limpkin/cdm324_backpack/pictures/cdm324_assembled_quarter.JPG

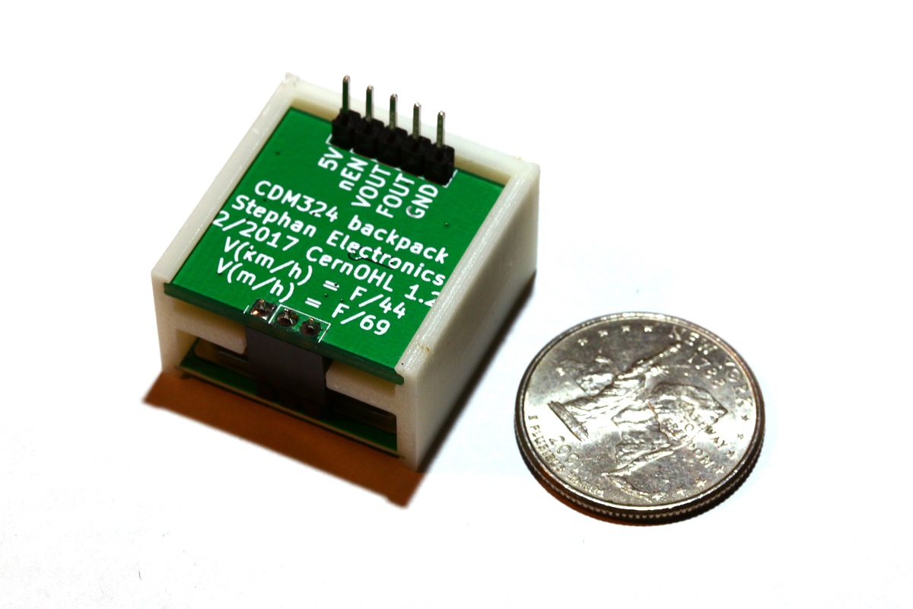
pictures/cdm324_assembled_quarter.JPG
