limpkin/cdm324_backpack/pictures/cdm324_assembled_patch.JPG

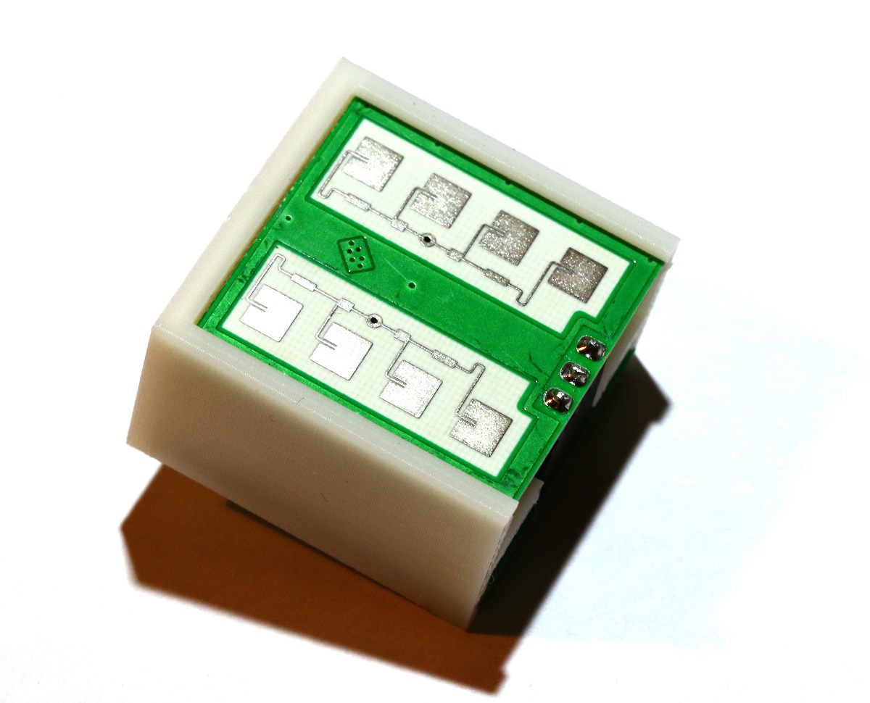
pictures/cdm324_assembled_patch.JPG
