limpkin/cdm324_backpack/pictures/cdm324_pcb1.JPG

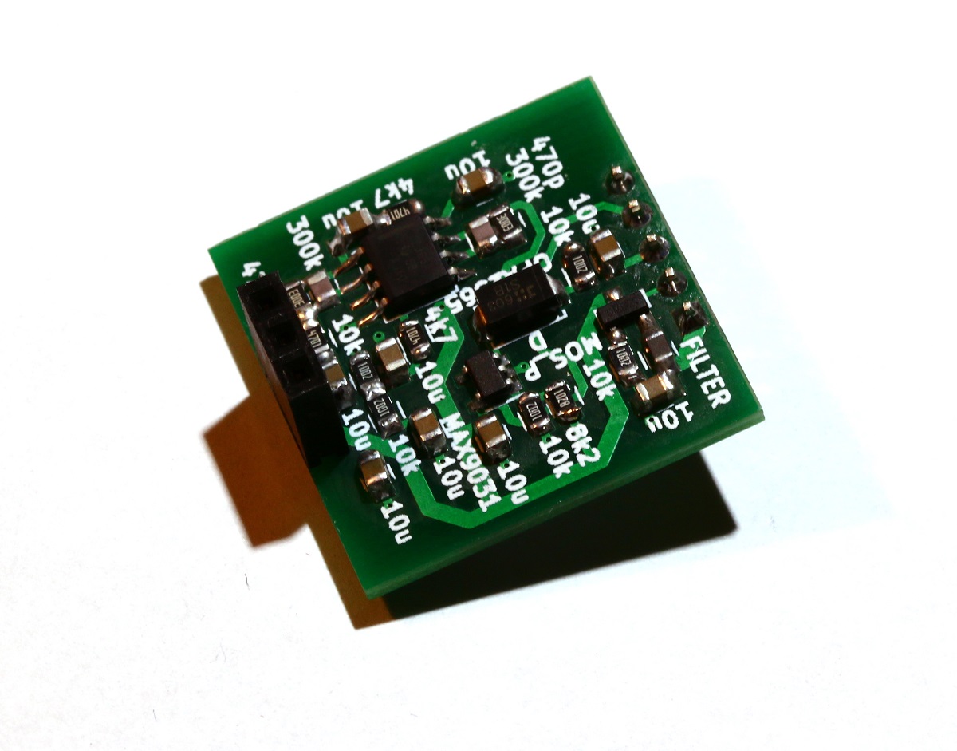
pictures/cdm324_pcb1.JPG
