limpkin/cdm324_backpack/pictures/cdm324_pcb2.JPG

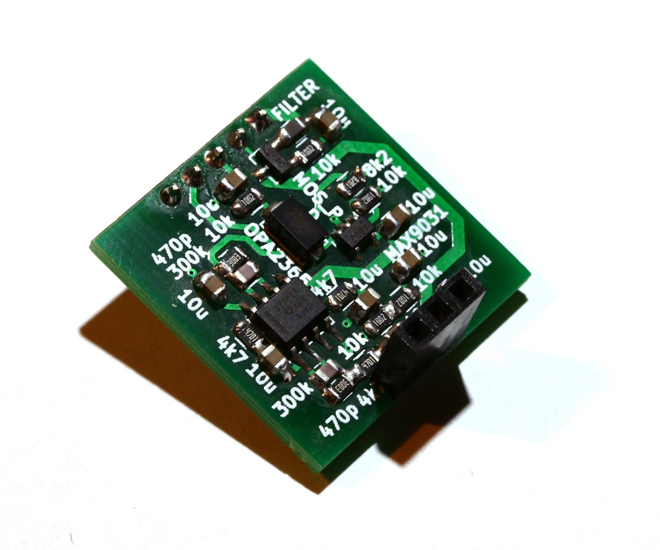
pictures/cdm324_pcb2.JPG
