limpkin/cdm324_backpack/pictures/cdm324_size.JPG

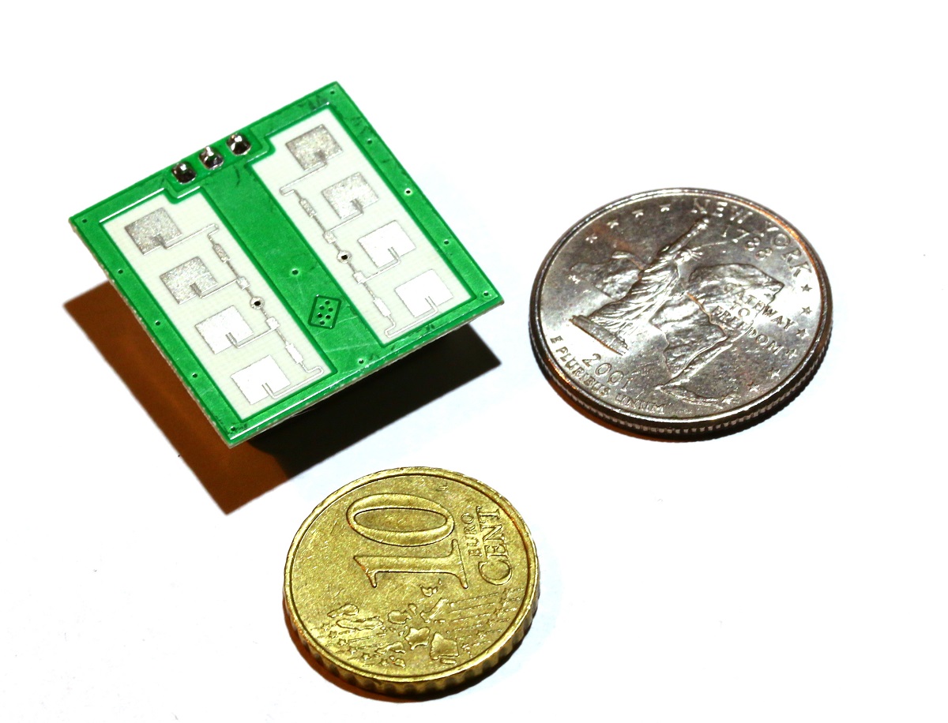
pictures/cdm324_size.JPG
