limpkin/cdm324_backpack/BoM.xlsx

 | Prototype Quantity | 10
Item | References | Qty | Manufacturer P/N | Manufacturer | Description | Package | Internet Link | Home ID | Part Status
1 | U1 | 1 | OPA2365AIDR | Texas Instruments | IC OPAMP GP 50MHZ RRO 8SOIC | 8-SOIC | http://www.digikey.com/product-detail/en/OPA2365AIDR/296-31704-1-ND/3505181 | ---- | Active
2 | R2 R3 R10 R11 R1 | 5 | RC0805FR-0710KL | Yageo | RES SMD 10K OHM 1% 1/8W 0805 | 0805 | http://www.digikey.com/product-detail/en/yageo/RC0805FR-0710KL/311-10.0KCRCT-ND/730482 | ---- | Active
3 | FB1 | 1 | HZ0805D102R-10 | Laird-Signal Integrity Products | FERRITE BEAD 1 KOHM 0805 1LN | 0805 (2012 Metric) | http://www.digikey.com/product-detail/en/HZ0805D102R-10/240-2397-1-ND/806757 | ---- | Active
4 | P2 | 1 | PPPC031LFBN-RC | Sullins Connector Solutions | CONN HEADER FEMALE 3POS .1" GOLD |  | http://www.digikey.com/product-detail/en/sullins-connector-solutions/PPPC031LFBN-RC/S7036-ND/810175 | ---- | Active
5 | C3 C4 C1 C2 C8 C5 C9 C11 C10 | 9 | CL21B106KOQNNNE | Samsung Electro-Mechanics America, Inc. | CAP CER 10UF 16V X7R 0805 | 0805 (2012 Metric) | http://www.digikey.com/product-detail/en/samsung-electro-mechanics-america-inc/CL21B106KOQNNNE/1276-2872-1-ND/3890958 | ---- | Active
6 | R4 R5 R6 | 3 | RC0805FR-074K7L | Yageo | RES SMD 4.7K OHM 1% 1/8W 0805 | 0805 | http://www.digikey.com/product-detail/en/yageo/RC0805FR-074K7L/311-4.70KCRCT-ND/730876 | ---- | Active
7 | R7 R8 | 2 | ERJ-6ENF5903V | Panasonic Electronic Components | RES SMD 590K OHM 1% 1/8W 0805 | 0805 | http://www.digikey.com/product-detail/en/panasonic-electronic-components/ERJ-6ENF5903V/P590KCCT-ND/119773 | ---- | Active
8 | C6 C7 | 2 | CC0805JRNPO9BN271 | Yageo | CAP CER 270PF 50V NPO 0805 | 0805 (2012 Metric) | http://www.digikey.com/product-detail/en/yageo/CC0805JRNPO9BN271/311-1116-1-ND/303026 | ---- | Active
9 | U2 | 1 | MAX9031AUK+T | Maxim Integrated | IC COMPARATOR VOLT SGL SOT23-5 | SOT-23-5 | http://www.digikey.com/product-detail/en/MAX9031AUK%2BT/MAX9031AUK%2BTCT-ND/774161 | ---- | Active
10 | R9 | 1 | RC0805FR-078K2L | Yageo | RES SMD 8.2K OHM 1% 1/8W 0805 | 0805 | http://www.digikey.com/product-detail/en/yageo/RC0805FR-078K2L/311-8.20KCRCT-ND/731094 | ---- | Active
11 | D1 | 1 | S1B-13-F | Diodes Incorporated | DIODE GEN PURP 100V 1A SMA | SMA | http://www.digikey.com/product-detail/en/diodes-incorporated/S1B-13-F/S1B-FDICT-ND/725064 | ---- | Active
12 | Q1 | 1 | DMP3098L-7 | Diodes Incorporated | MOSFET P-CH 30V 3.8A SOT23-3 | SOT-23-3 | http://www.digikey.com/product-detail/en/diodes-incorporated/DMP3098L-7/DMP3098LDICT-ND/1964773 | ---- | Active
13 | P1 | 1 |  |  | Standard 5x1 0.1" straight male header
 | Total: | 28
