limpkin/cdm324_backpack/mechanics/assembly.STL

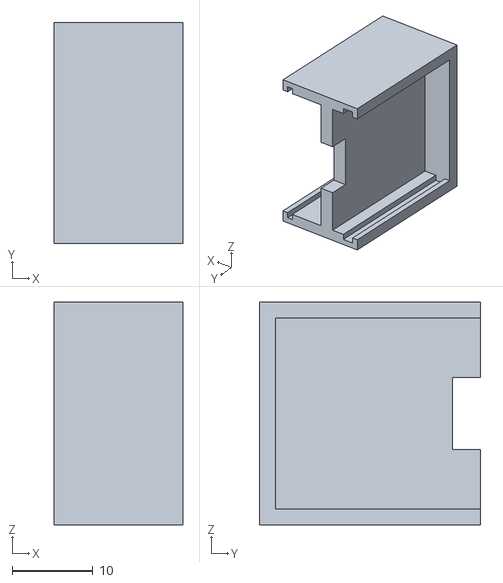
[picture p6: CAD file, 2017-03-27]
mechanics/assembly.STL
16.0 x 27.5 x 27.7
