limpkin/cdm324_backpack/schematics.pdf

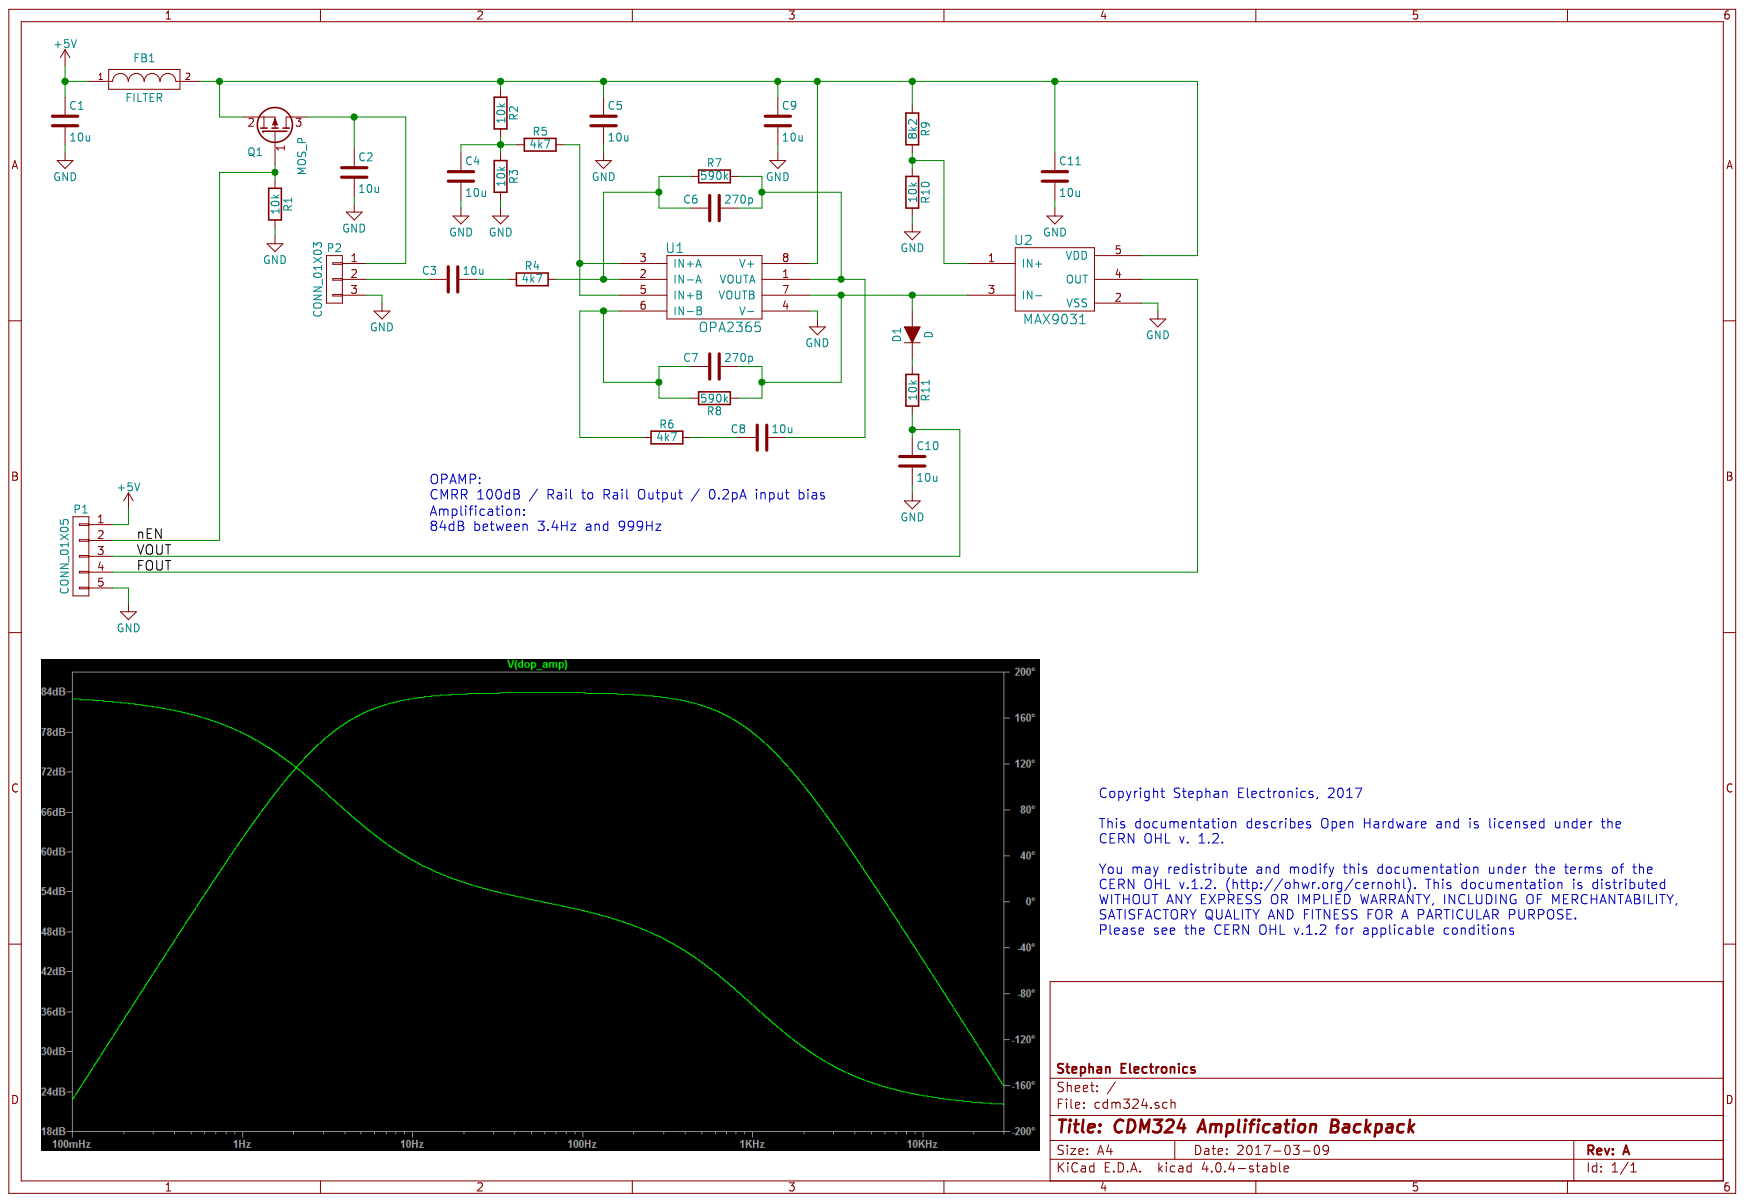
[picture p7: page 1]
