limpkin/cdm324_backpack/kicad/cdm324.kicad_pcb

## KiCad design kicad/cdm324.kicad_pcb (2017-03-27)

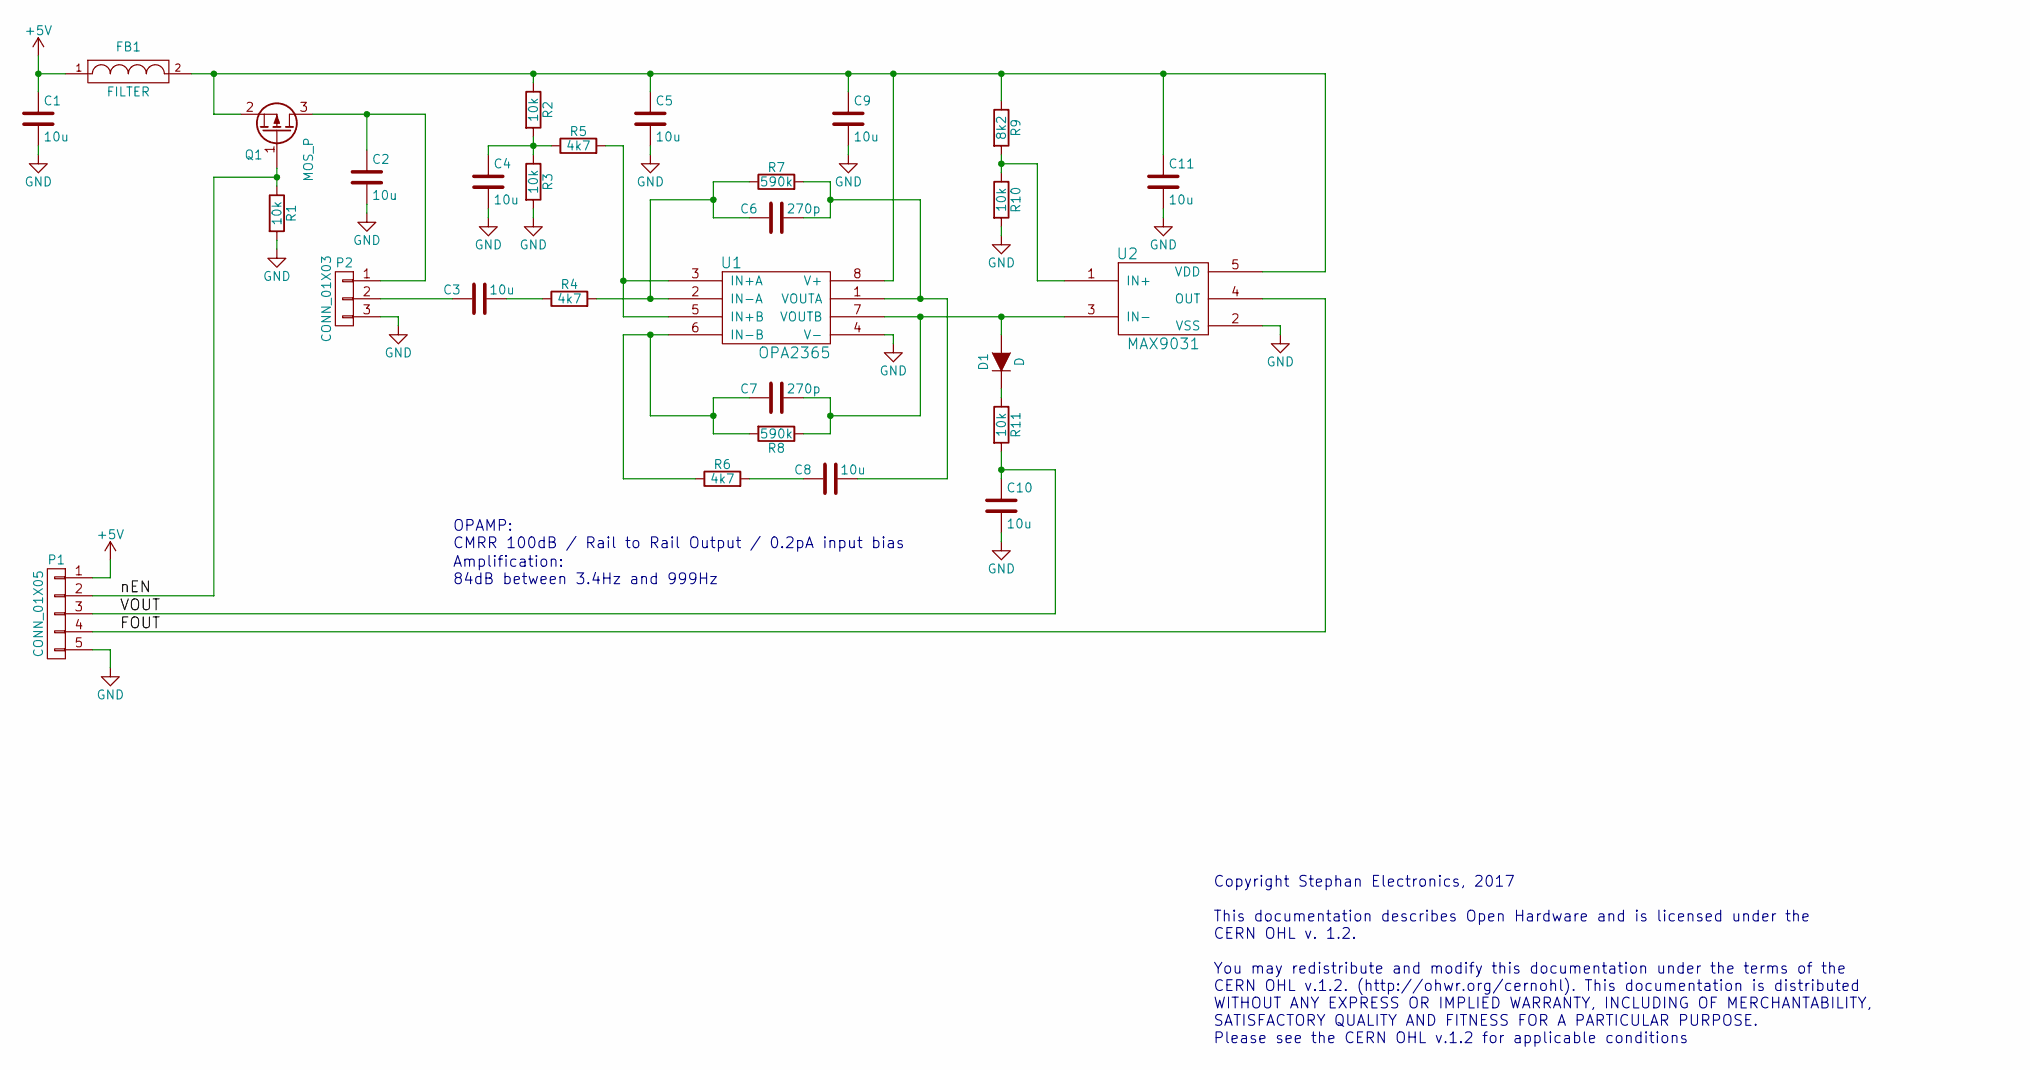
[picture p8: schematic cdm324.sch, CDM324 Amplification Backpack]

Parts:
C1, C2, C3, C4, C5, C8, C9, C10, C11: 10u; C_0805
C6, C7: 270p; C_0805
D1: D; DIODE_SMA
FB1: FILTER; C_0805
P1: CONN_01X05; Pin_Header_Straight_1x05_Pitch2.54mm
P2: CONN_01X03; Pin_Header_Straight_1x03_Pitch2.54mm
Q1: MOS_P; SOT23-3
R1, R2, R3, R10, R11: 10k; R_0805
R4, R5, R6: 4k7; R_0805
R7, R8: 590k; R_0805
R9: 8k2; R_0805
U1: OPA2365; SOIC-8-N
U2: MAX9031; SOT-23-5

Connections:
+5V: C1.1, FB1.1, P1.1
/FOUT: P1.4, U2.4 (OUT)
/VOUT: C10.1, P1.3, R11.2
/nEN: P1.2, Q1.1 (G), R1.1
GND: C1.2, C2.2, C4.2, C5.2, C9.2, C10.2, C11.2, P1.5, P2.3, R1.2, R3.2, R10.2, U1.4 (V-), U2.2 (VSS)
unnamed: C2.1, P2.1, Q1.3 (D)
unnamed: C3.1, P2.2
unnamed: C3.2, R4.1
unnamed: C4.1, R2.2, R3.1, R5.1
unnamed: C6.1, R4.2, R7.1, U1.2 (IN-A)
unnamed: C6.2, C8.2, R7.2, U1.1 (VOUTA)
unnamed: C7.1, R6.1, R8.2, U1.6 (IN-B)
unnamed: C7.2, D1.2 (A), R8.1, U1.7 (VOUTB), U2.3 (IN-)
unnamed: C8.1, R6.2
unnamed: C5.1, C9.1, C11.1, FB1.2, Q1.2 (S), R2.1, R9.1, U1.8 (V+), U2.5 (VDD)
unnamed: D1.1 (K), R11.1
unnamed: R5.2, U1.3 (IN+A), U1.5 (IN+B)
unnamed: R9.2, R10.1, U2.1 (IN+)

Notes on the sheet:
Amplification: 84dB between 3.4Hz and 999Hz
OPAMP: CMRR 100dB / Rail to Rail Output / 0.2pA input bias
Copyright Stephan Electronics, 2017 This documentation describes Open Hardware and is licensed under the CERN OHL v. 1.2. You may redistribute and modify this documentation under the terms of the CERN OHL v.1.2. (http://ohwr.org/cernohl). This documentation is distributed WITHOUT ANY EXPRESS OR IMP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

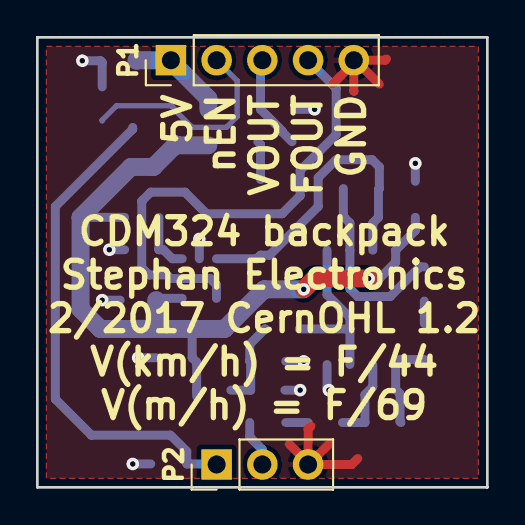
[picture p9: board cdm324.kicad_pcb from above]

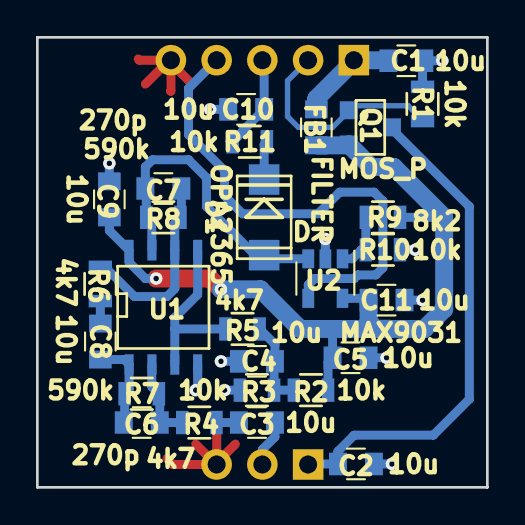
[picture p10: board cdm324.kicad_pcb from below]

Board: 2 copper layers, 25.0 x 25.0 mm, 29 parts (27 on the bottom side), 18 nets.
