limpkin/cdm324_backpack/pictures/cdm324_assembled.JPG

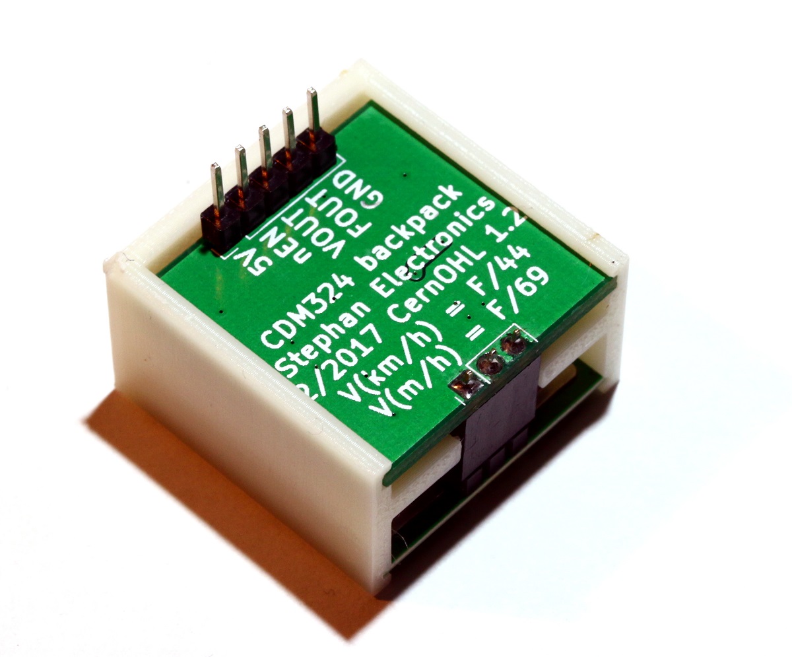
pictures/cdm324_assembled.JPG
