limpkin/cdm324_backpack/(threads)

Thread 1 (2017-04-06):

Have questions under the advice

adz1122, 2017-04-06:
See you this creation, really very powerful, I as an electronic enthusiast, but also want to do a play, but did not find your antenna file, the antenna with HB100 can? Thank you!

limpkin, 2017-04-06:
the cdm324 itself must be bought on ebay or similar.

Closed 2017-04-06.

Thread 2 (2019-03-12):

If I want at 50 meters distance?

hoolanla, 2019-03-12:
I got it But from the test, it can only work for 10 meters distance. If I want at 50 meters distance, what should I do? Please also recommend

limpkin, 2019-03-12:
you'll need to change the resistor values to amplify the signal more.

hoolanla, 2019-03-12:
You mean having to fix the CDM324_backpack again? Oh, I expect the CDM324_backpack , which has an extended circuit, can do 50 meters distance. Do you have other products? That can extend the signal up to 50 meters distance.
Thank you

limpkin, 2019-03-28:
I'm afraid no.

Closed 2019-03-28.

Thread 3 (2019-03-28):

How can we do if we don't know how to use Isis

FrenchStudent, 2019-03-28:
Hi, I'm a student and I want to know if it's possible to get the fritzing of this project.
Ty for you're answer.

limpkin, 2019-03-28:
we don't have the fritzing.

will-code-for-pizza, 2023-10-03:
Hi Limpkin... So if you do nt have Fritzing... would it be possible for you to draw a simple cabeling schema for us how to connect the CDM324 to arduino ?

limpkin, 2023-10-03:
are you sure you're commenting on the right issue in the right repository?
do you maybe meant to comment on https://github.com/limpkin/cdm324_fft ?

Closed 2019-03-28.

Thread 4 (2020-04-03):

eagle or gerber files

geologic, 2020-04-03:
Hi

Nice work, thanks for sharing.

I would like to test this sensor but don't have experience with kicad.
Any chance to have a Eagle version of the PCB? Or at least the GERBER files...

Thanks

Thread 5 (2021-06-18):

Bad output

ITstreet1, 2021-06-18:
I made exactly as you did. With the same components, and I get nothing. If I connect fOut to analog pin I can see values from 509 to 512. CMD324 is the radar.

will-code-for-pizza, 2023-10-02:
The cdm324 from https://www.limpkin.fr is not well documented.

f.e. I miss:
* breadboard cabling
* example Arduino sketches (the one from https://github.com/limpkin/cdm324_backpack/tree/master/arduino/freq_counter give no result...)
* detailed information about the capabilities of the onboard connectors
  (https://www.limpkin.fr/index.php?post/2022/03/31/CDM324-Doppler-Motion-Sensor-Backpack%2C-now-with-FFTs%21)
  especially this picture https://www.limpkin.fr/public/cdm324_v2/exp_pinout.png

limpkin, 2023-10-03:
this repository is for a previous version of the cdm324 project.

Thread 6 (2024-03-29):

Contact and Help pls

QoSi, 2024-03-29:
Hello Mathieu, I tried to send a message via LinkedIn, unfortunately it costs a lot of money there, so I hope I can reach you with this.

I live on a private street where many children play a lot, especially on Saturdays. The street is also marked that it is a dead end and private.
From the main road there is a supermarket right at the entrance to the private road and there is usually a huge rush of cars there on Saturdays.
Unfortunately, they also get lost on the private road and take out their shopping frenzy on the accelerator pedal there. I worry about my child and the children who play there worriedly in moments like this.
That's why I found this here from you and had the PCB made. I also get a level that I can read via VOUT with an ESP8266. However, I understood it to mean that the speed can only be measured to a decent extent with FOUT.
Unfortunately I don't get a signal there at the FOUT and I don't really know how to test it because I only have a voltmeter available.
I would like to attach a small LED matrix to the fence to show the vehicles their speed with smiles and to display a sad smile if the speed is too high. Hope you can still help me, even if the board is already outdated and replaced with a new one.

Do I have to activate the board via the nEN pin and if so, how?
Does it even work with an ESP8266?
Do I have to use all PINs like you did in the video, since only PIN 4 is specified in the Arduino Scetch?

I would be happy if you could help me, thank you very much!

limpkin, 2024-03-29:
Hello there,

Do I correctly understand that you're using this board, connected to an
esp8266 development board?

With only a voltmeter testing may get tricky... Does it have a "frequency"
position? If so you could probe the fout signal to try to get a frequency
reading.

You don't need to use the nEN pin, by default the sensor is enabled

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

QoSi, 2024-03-29:
hi, thx for the reply,i try to use the esp8266 wemos d1 mini, but i prepared a esp32 s2 mini and one old arduino board what i found in my basememt and hope maybe i get something to can say the pcb working.and no, my voltmeter dont have a frequency position, so yes i cant not realy say the hardware working and i can go the next steps in the code.and if i want use the nEN pin, how to conect it? to gnd or vcc? and only for few seconds or static conection?many thanks for you help!Gesendet mit der mobilen Mail AppAm 29.03.24 um 10:33 schrieb Mathieu

                    Von: "Mathieu" ***@***.***>Datum: 29. März 2024An: "limpkin/cdm324_backpack" ***@***.***>Cc: "Author" ***@***.***>,"QoSi" ***@***.***>Betreff: Re: [limpkin/cdm324_backpack] Contact and Help pls (Issue #6)

Hello there,

Do I correctly understand that you're using this board, connected to an

esp8266 development board?

With only a voltmeter testing may get tricky... Does it have a "frequency"

position? If so you could probe the fout signal to try to get a frequency

reading.

You don't need to use the nEN pin, by default the sensor is enabled

On Fri, 29 Mar 2024, 01:36 QoSi, ***@***.***> wrote:

> Hello Mathieu, I tried to send a message via LinkedIn, unfortunately it

> costs a lot of money there, so I hope I can reach you with this.

>

> I live on a private street where many children play a lot, especially on

> Saturdays. The street is also marked that it is a dead end and private.

> From the main road there is a supermarket right at the entrance to the

> private road and there is usually a huge rush of cars there on Saturdays.

> Unfortunately, they also get lost on the private road and take out their

> shopping frenzy on the accelerator pedal there. I worry about my child and

> the children who play there worriedly in moments like this.

> That's why I found this here from you and had the PCB made. I also get a

> level that I can read via VOUT with an ESP8266. However, I understood it to

> mean that the speed can only be measured to a decent extent with FOUT.

> Unfortunately I don't get a signal there at the FOUT and I don't really

> know how to test it because I only have a voltmeter available.

> I would like to attach a small LED matrix to the fence to show the

> vehicles their speed with smiles and to display a sad smile if the speed is

> too high. Hope you can still help me, even if the board is already outdated

> and replaced with a new one.

>

> Do I have to activate the board via the nEN pin and if so, how?

> Does it even work with an ESP8266?

> Do I have to use all PINs like you did in the video, since only PIN 4 is

> specified in the Arduino Scetch?

>

> I would be happy if you could help me, thank you very much!

>

> —

> Reply to this email directly, view it on GitHub

> <https://github.com/limpkin/cdm324_backpack/issues/6>, or unsubscribe

> <https://github.com/notifications/unsubscribe-auth/ABPCNM4EBWRJ4RZFGCYKE5LY2SSRLAVCNFSM6AAAAABFNWGZTKVHI2DSMVQWIX3LMV43ASLTON2WKOZSGIYTIMZZGQZTSMY>

> .

> You are receiving this because you are subscribed to this thread.Message

> ID: ***@***.***>

>

—Reply to this email directly, view it on GitHub, or unsubscribe.You are receiving this because you authored the thread.Message ID: ***@***.***>

limpkin, 2024-03-29:
Leave the nen pin non connected for the moment.
If I remember correctly, the outputs are 5v so if you don't want to damage
your board you'll need a resistor divider.
Maybe as a first step you could just have a firmware running that outputs
the state of the connected fout?

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
